crystalliu314/MMTK/Test Jig/renderWithBoard.JPG

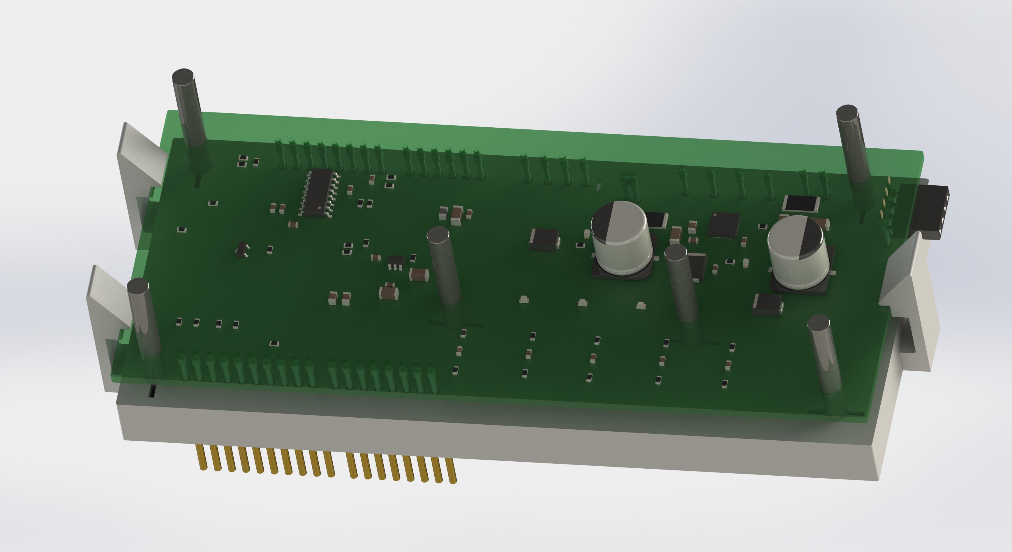
Test Jig/renderWithBoard.JPG
