crystalliu314/MMTK/Test Jig/MMTK - For Test Bed v1.5.step.SLDASM

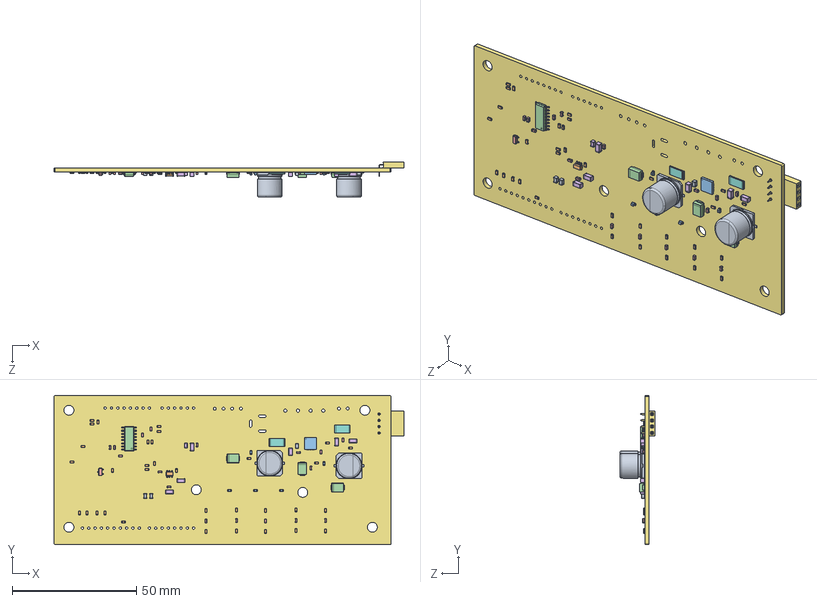
[picture p2: CAD file, 2020-12-12]
Test Jig/MMTK - For Test Bed v1.5.step.SLDASM
140.7 x 60.0 x 14.2 mm
SOLID.step x 3
SOLID-0.step x 33
SOLID-1.step x 5
SOLID-2.step x 3
SOLID-3.step x 17
SOLID-4.step x 6
SOLID-5.step
SOLID-6.step x 2
SOLID-7.step x 2
SOLID-8.step
SOLID-9.step
SOLID-10.step
SOLID-11.step
SOLID-12.step
COMPOUND.step
