crystalliu314/MMTK/Test Jig/MMTK - For Test Bed v1.5.SLDASM

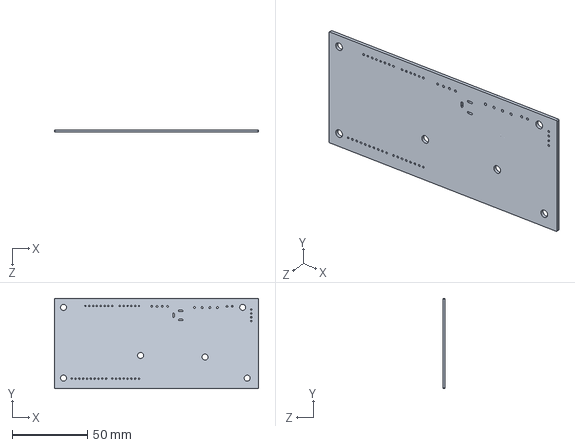
[picture p3: CAD file, 2020-12-12]
Test Jig/MMTK - For Test Bed v1.5.SLDASM
135.5 x 60.0 x 1.60 mm
