crystalliu314/MMTK/Test Jig/Pogo Pin/Pin Assembly.SLDASM

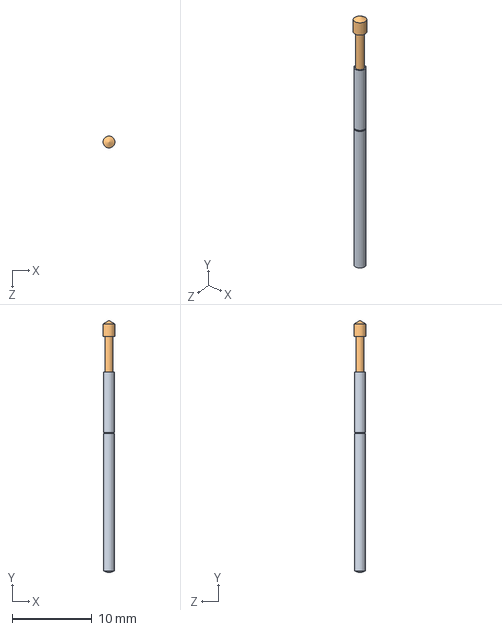
[picture p4: CAD file, 2020-12-12]
Test Jig/Pogo Pin/Pin Assembly.SLDASM
1.50 x 31.7 x 1.50 mm
Outer Sleeve
Inner Pin
