crystalliu314/MMTK/Test Jig/Pogo Pin/Test Jig With Pins.SLDASM

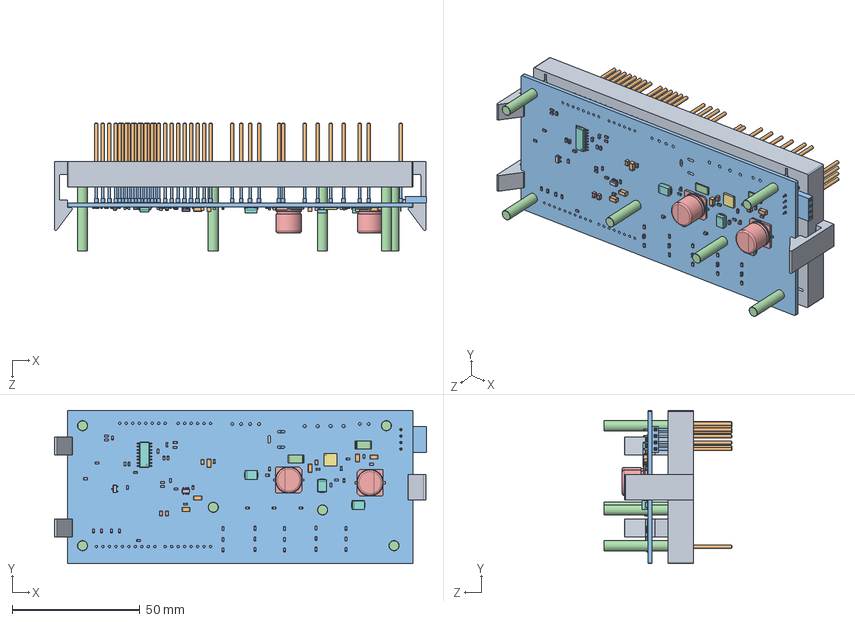
[picture p5: CAD file, 2020-12-12]
Test Jig/Pogo Pin/Test Jig With Pins.SLDASM
145.7 x 60.0 x 50.2 mm
Test Jig Pins Holder
Outer Sleeve x 50
Inner Pin x 50
4x30mm pin x 6
SOLID.step x 3
SOLID-0.step x 33
SOLID-1.step x 5
SOLID-2.step x 3
SOLID-3.step x 17
SOLID-4.step x 6
SOLID-5.step
SOLID-6.step x 2
SOLID-7.step x 2
SOLID-8.step
SOLID-9.step
SOLID-10.step
SOLID-11.step
SOLID-12.step
COMPOUND.step
