crystalliu314/MMTK/Test Jig/Pogo Pin/4x30mm pin.SLDPRT

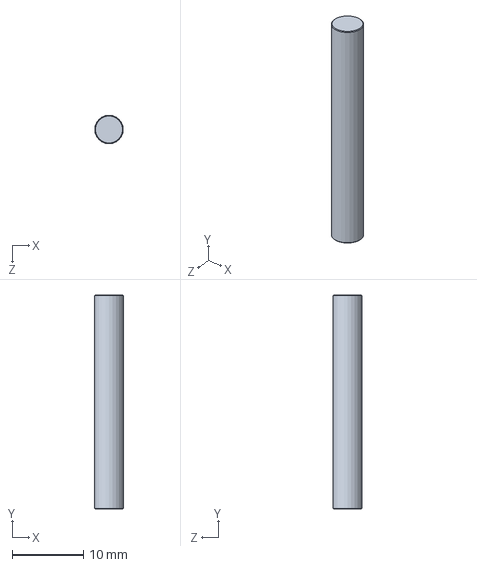
[picture p6: CAD file, 2020-12-12]
Test Jig/Pogo Pin/4x30mm pin.SLDPRT
4.00 x 30.0 x 4.00 mm
