crystalliu314/MMTK/Test Jig/Pogo Pin/Outer Sleeve.SLDPRT

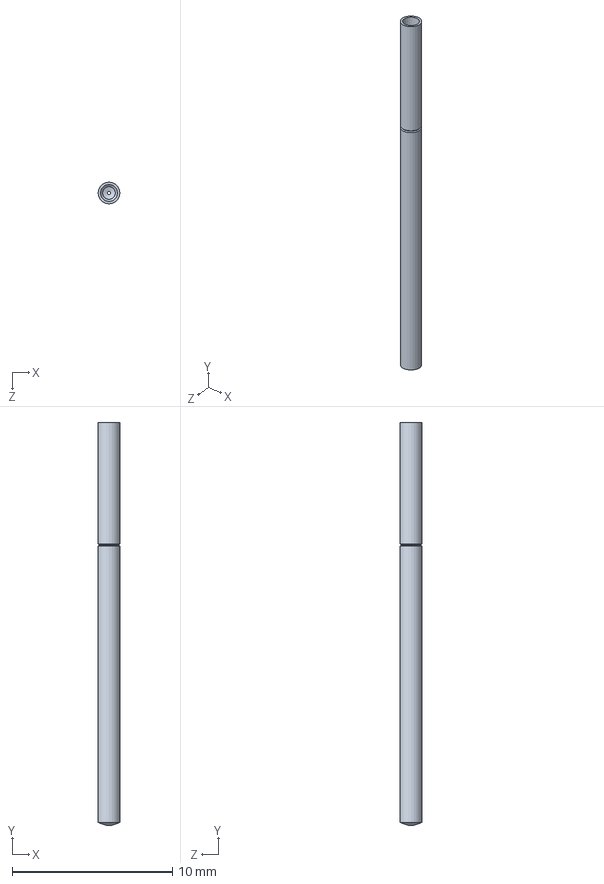
[picture p7: CAD file, 2020-12-12]
Test Jig/Pogo Pin/Outer Sleeve.SLDPRT
1.36 x 25.2 x 1.36 mm
