crystalliu314/MMTK/Test Jig/Test Jig Pins Holder.SLDPRT

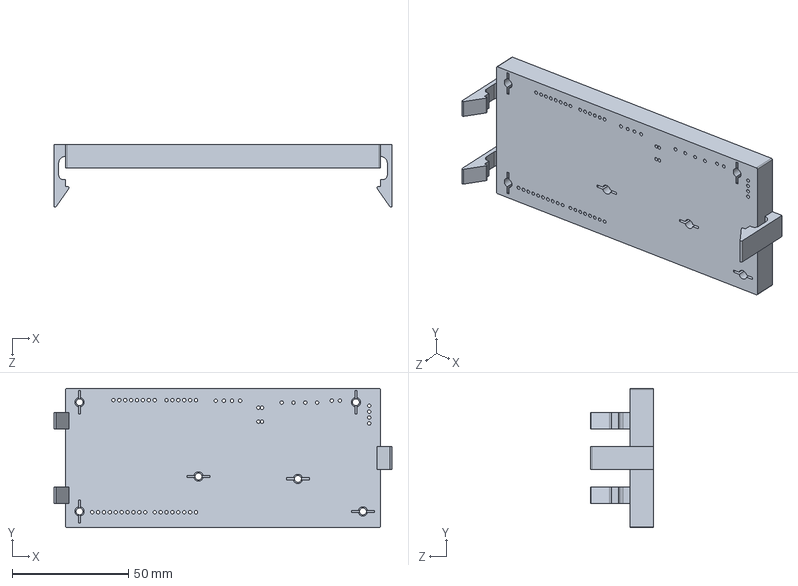
[picture p8: CAD file, 2020-12-12]
Test Jig/Test Jig Pins Holder.SLDPRT
145.5 x 60.0 x 26.9 mm
