crystalliu314/MMTK/Test Jig/Pogo Pin/Inner Pin.SLDPRT

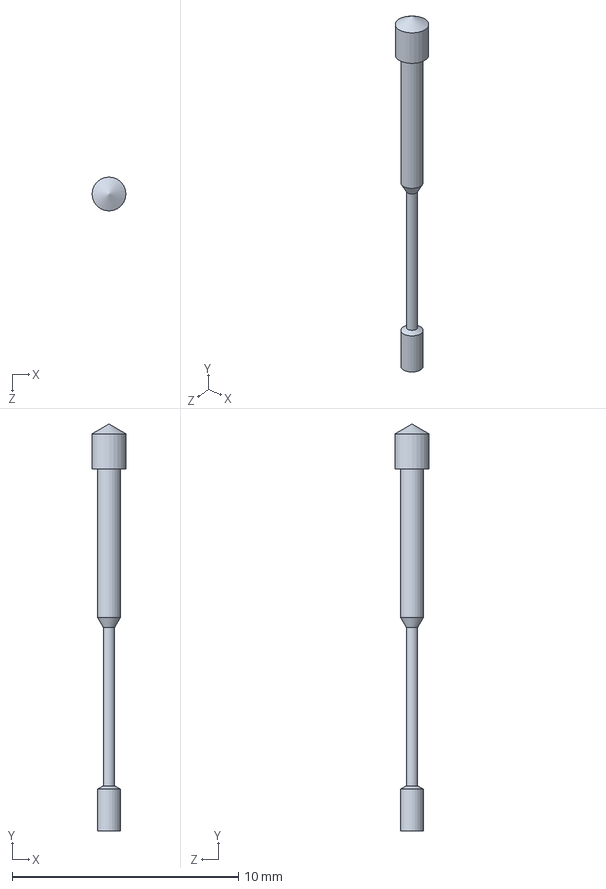
[picture p9: CAD file, 2020-12-12]
Test Jig/Pogo Pin/Inner Pin.SLDPRT
1.50 x 18.0 x 1.50 mm
