crystalliu314/MMTK/Test Jig/Test Holes Block.SLDPRT

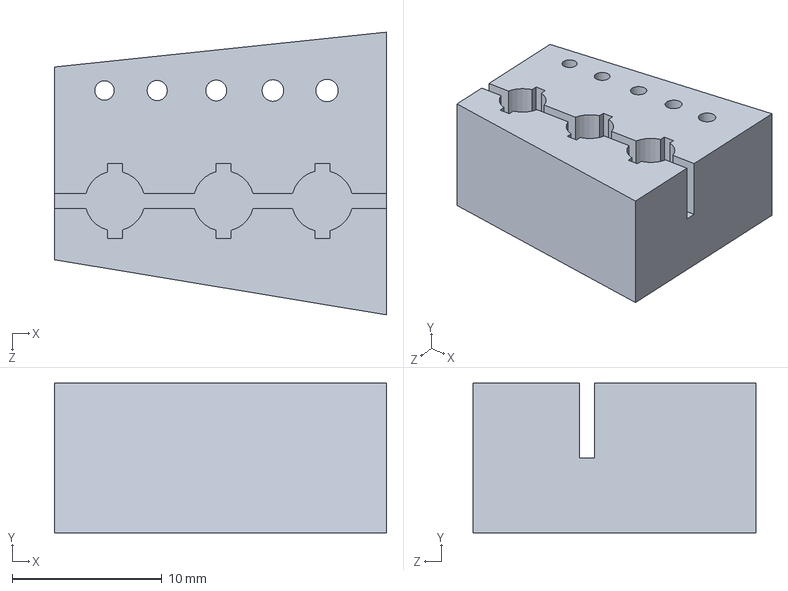
[picture p10: CAD file, 2020-12-12]
Test Jig/Test Holes Block.SLDPRT
22.2 x 10.0 x 18.9 mm
