crystalliu314/MMTK/(list of files, cad)

Other CAD files:
Test Jig/MMTK - For Test Bed v1.5.SLDPRT
Test Jig/Test Holes Block.3MF
Test Jig/Test Holes Block.STL
Test Jig/Test Jig Pins Holder.STL
