crystalliu314/MMTK/Test Data/MMTK First Tests.xlsx

Sheet: Sheet1
SPEED | POSITION | LOADCELL | FEEDBACK_COUNT | STATE | ESTOP | STALL | DIRECTION | INPUT_VOLTAGE | POSITION | LOADCELL
0 | 0 | 6.38 | 0 | 1 | 1 | 0 | 0 | 12.32 | 0.0625 | 6.38
0 | 0 | 6.39 | 0 | 1 | 1 | 0 | 0 | 12.27 | 0 | 6.39
0 | 0 | 6.39 | 0 | 1 | 1 | 0 | 0 | 12.3 | 0 | 6.39
0 | 0 | 6.39 | 0 | 1 | 1 | 0 | 0 | 12.21 | 0 | 6.39
0 | 0 | 6.39 | 0 | 1 | 1 | 0 | 0 | 12.3 | 0 | 6.39
0 | 0 | 6.38 | 0 | 1 | 1 | 0 | 0 | 12.17 | 0 | 6.38
0 | 0 | 6.38 | 0 | 1 | 1 | 0 | 0 | 12.29 | 0 | 6.38
0 | 0 | 6.38 | 0 | 1 | 1 | 0 | 0 | 12.17 | 0 | 6.38
0 | 0 | 6.37 | 0 | 1 | 1 | 0 | 0 | 12.23 | 0 | 6.37
0 | 0 | 6.38 | 0 | 1 | 1 | 0 | 0 | 12.32 | 0 | 6.38
0 | 0 | 6.37 | 0 | 1 | 1 | 0 | 0 | 12.17 | 0 | 6.37
0 | 0 | 6.38 | 0 | 1 | 1 | 0 | 0 | 12.27 | 0 | 6.38
0 | 0 | 6.39 | 0 | 1 | 1 | 0 | 0 | 12.34 | 0 | 6.39
0 | 0 | 6.39 | 0 | 1 | 1 | 0 | 0 | 12.17 | 0 | 6.39
0 | 0 | 6.41 | 0 | 2 | 1 | 0 | 0 | 12.27 | 0 | 6.41
0 | 0 | 6.39 | 0 | 2 | 0 | 0 | 0 | 12.11 | 0 | 6.39
0 | 0 | 6.37 | 0 | 2 | 0 | 0 | 0 | 12.23 | 0 | 6.37
0 | 0 | 6.37 | 0 | 2 | 0 | 0 | 0 | 12.11 | 0 | 6.37
0 | 0 | 6.38 | 0 | 2 | 0 | 0 | 0 | 12.17 | 0 | 6.38
0 | 0 | 6.36 | 0 | 2 | 0 | 0 | 0 | 12.27 | 0 | 6.36
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
