crystalliu314/MMTK/Test Jig/render.JPG

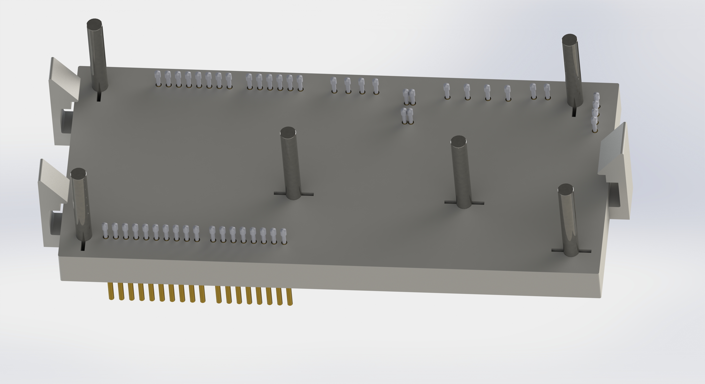
Test Jig/render.JPG
