crystalliu314/MMTK/PCB/MMTK.pdf

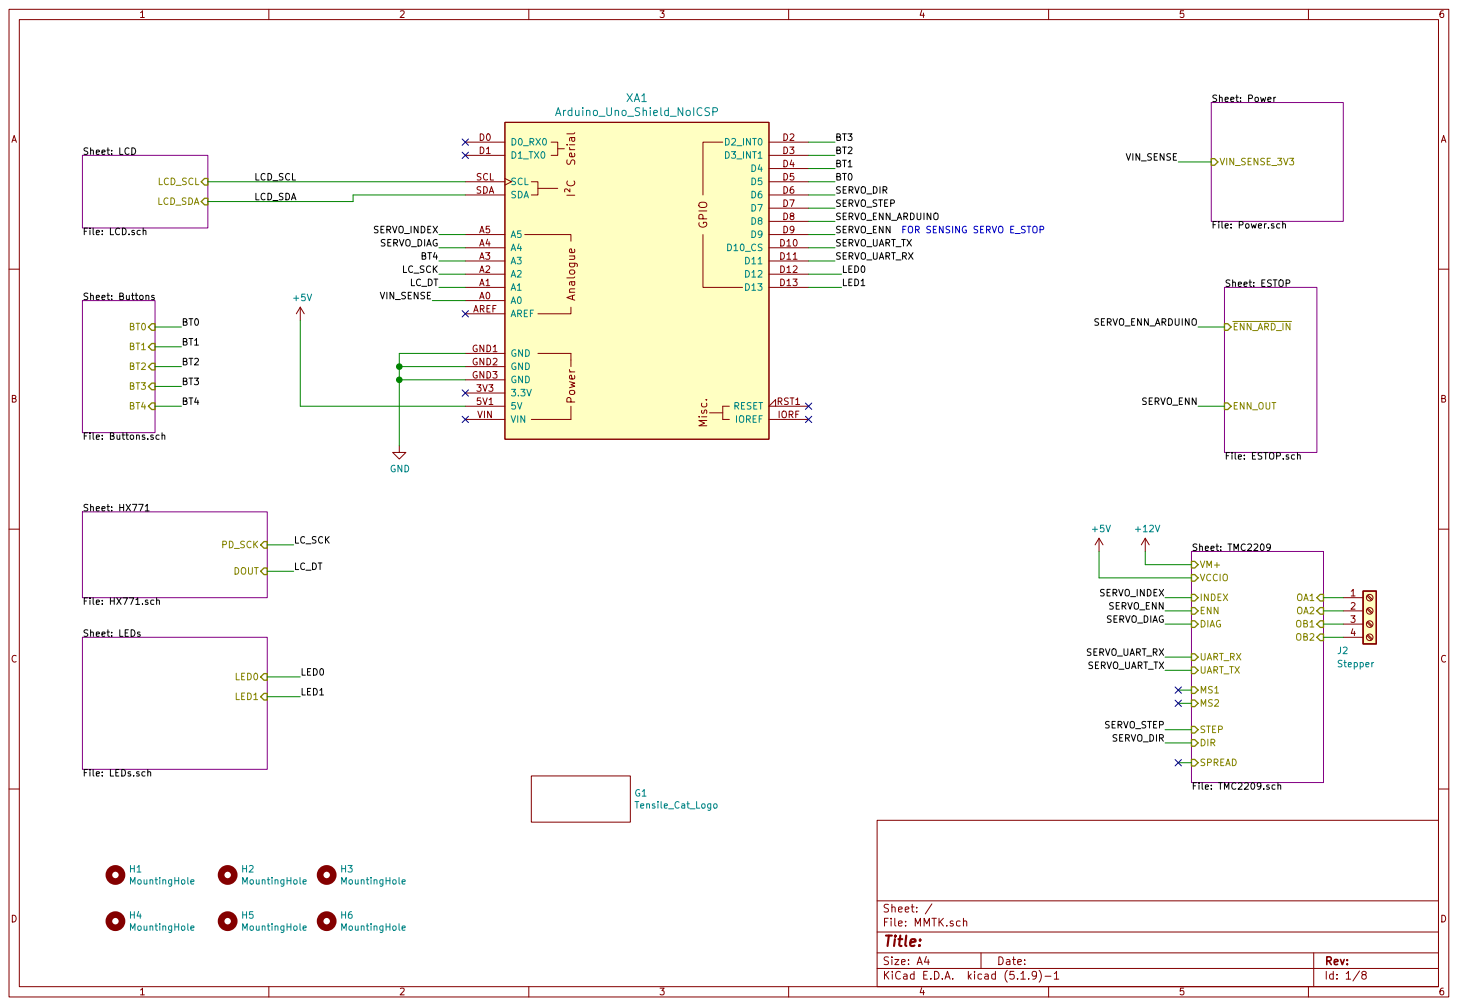
[picture p12: page 1]

Sheet: Power File: Power.sch VIN_SENSE_3V3

Id: 1/8 Title: File: MMTK.sch Sheet: /

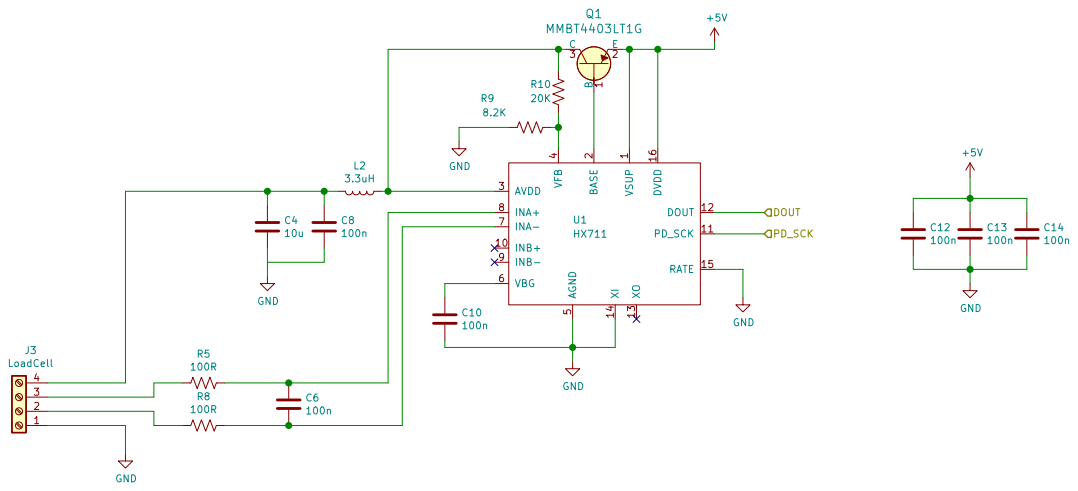
[picture p13: page 2]

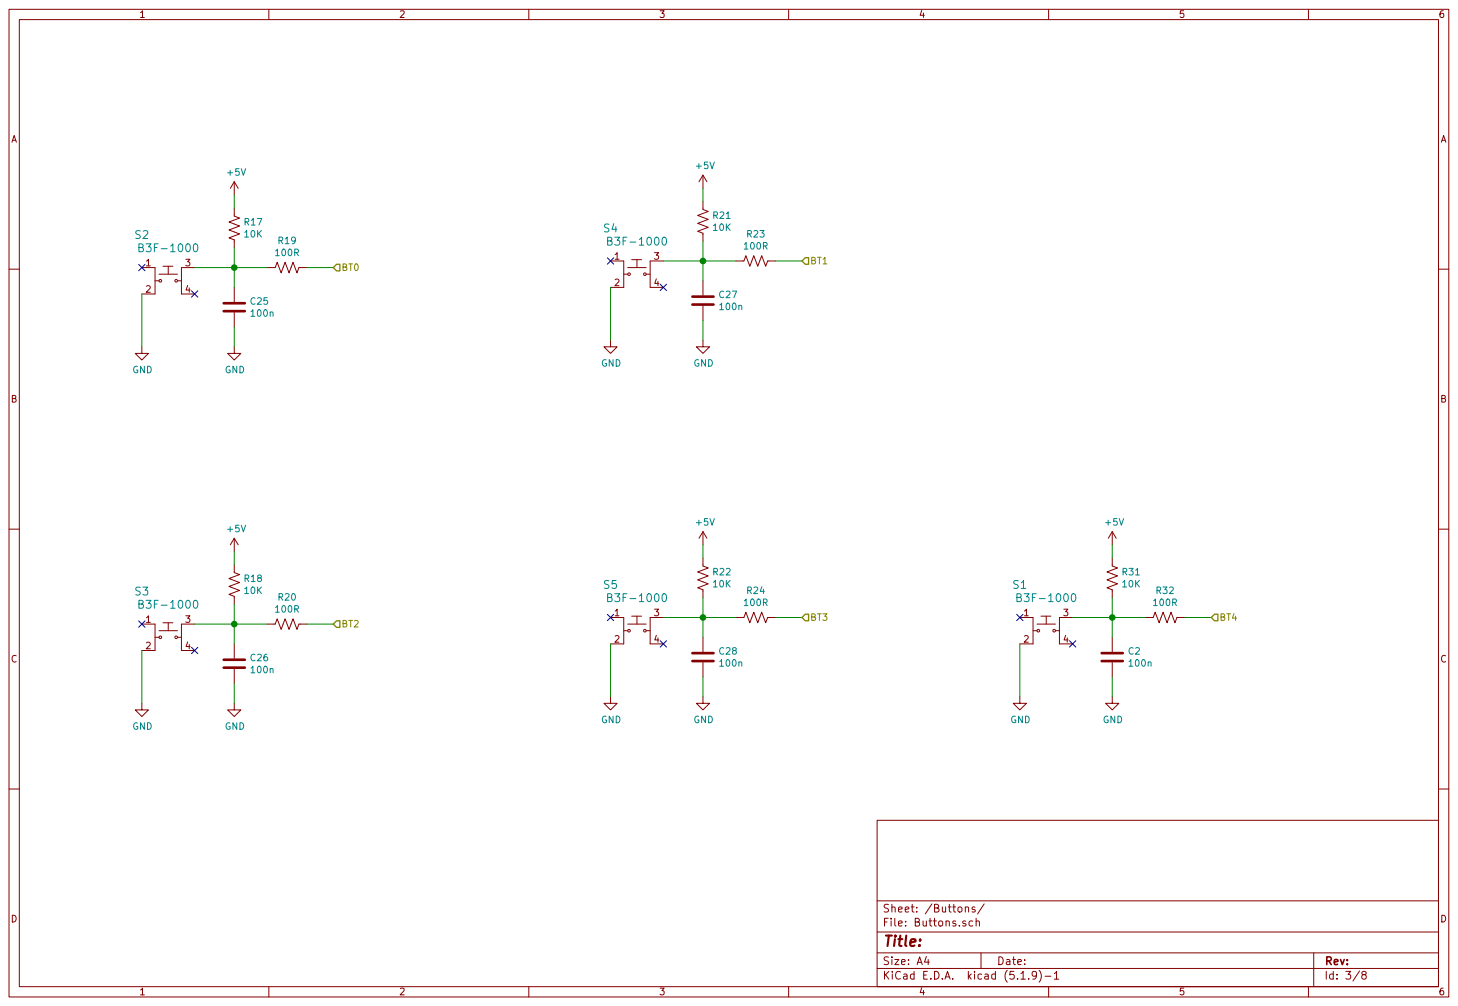
[picture p14: page 3]

Id: 3/8 Title: File: Buttons.sch Sheet: /Buttons/ R22

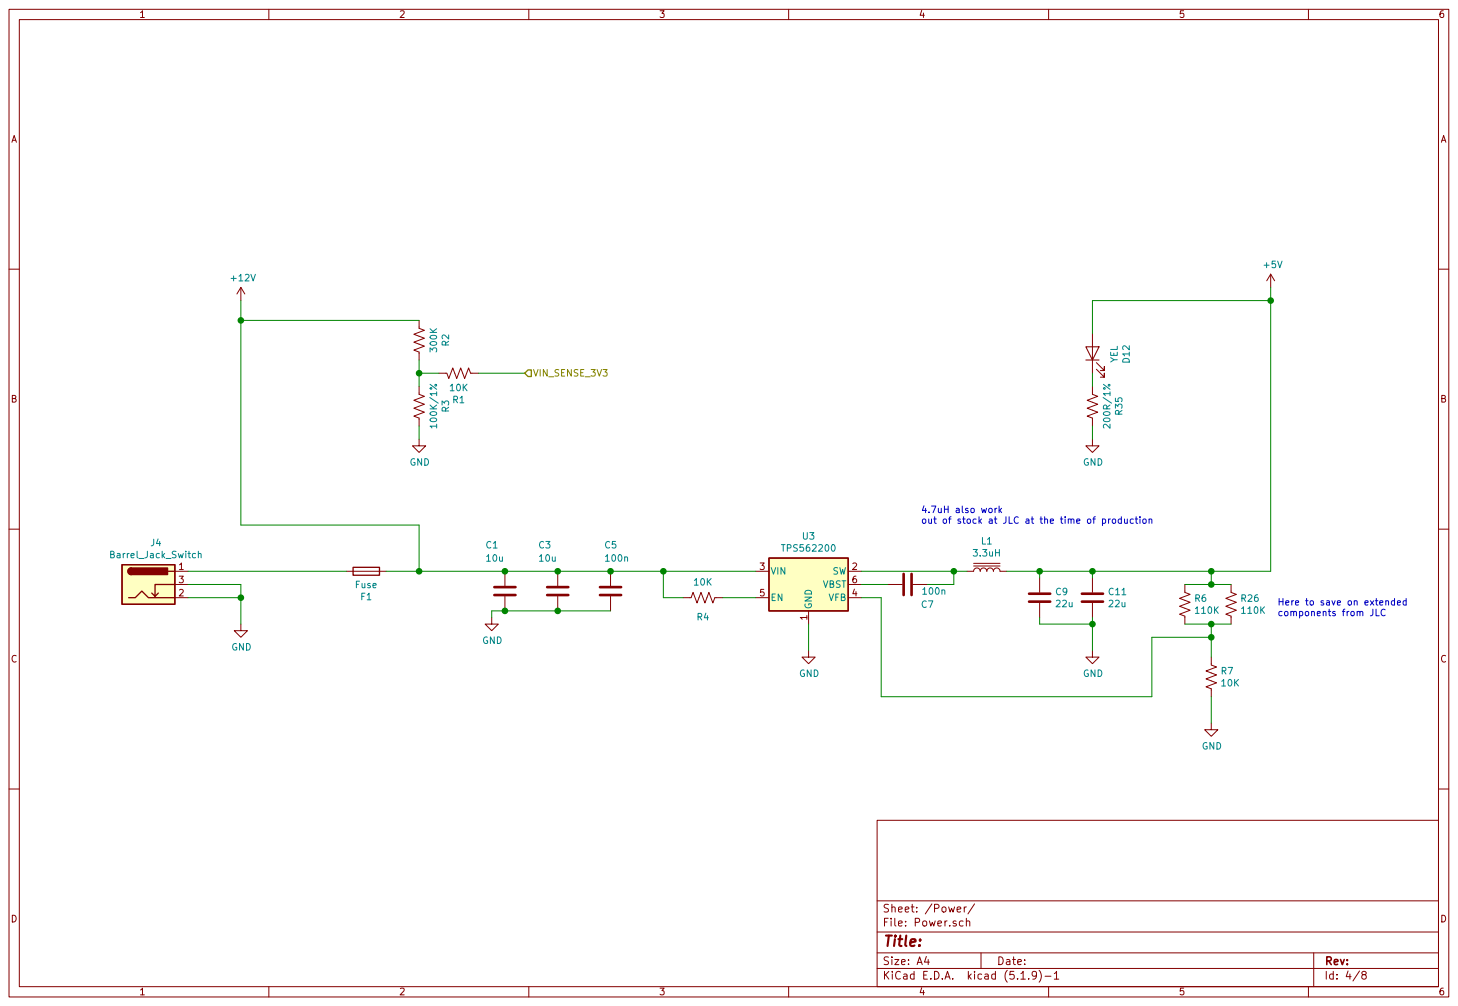
[picture p15: page 4]

4.7uH also work out of stock at JLC at the time of production

1 SW 2 VIN 3 VFB 4 EN 5 VBST 6 U3 TPS562200 GND R7

Id: 4/8 Title: File: Power.sch Sheet: /Power/ GND

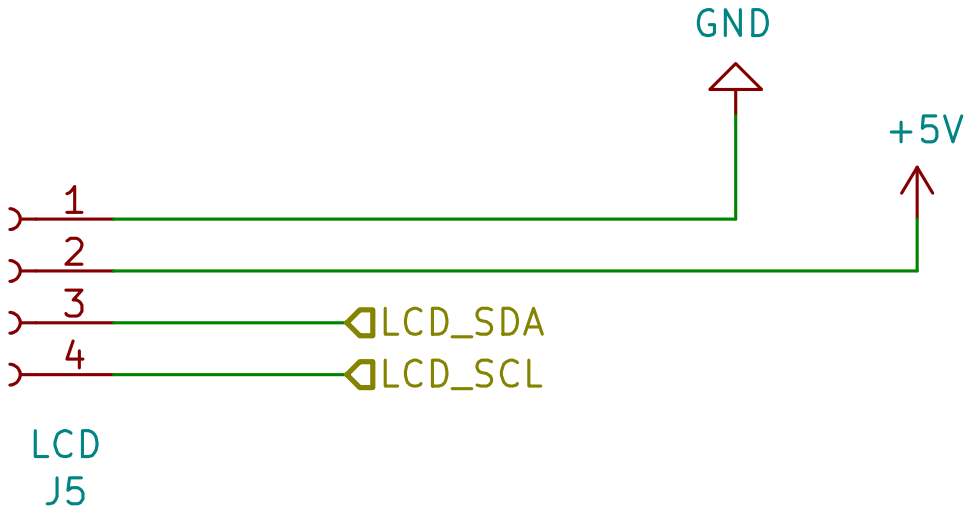
[picture p16: page 5]

Id: 5/8 Title: File: LCD.sch Sheet: /LCD/ GND

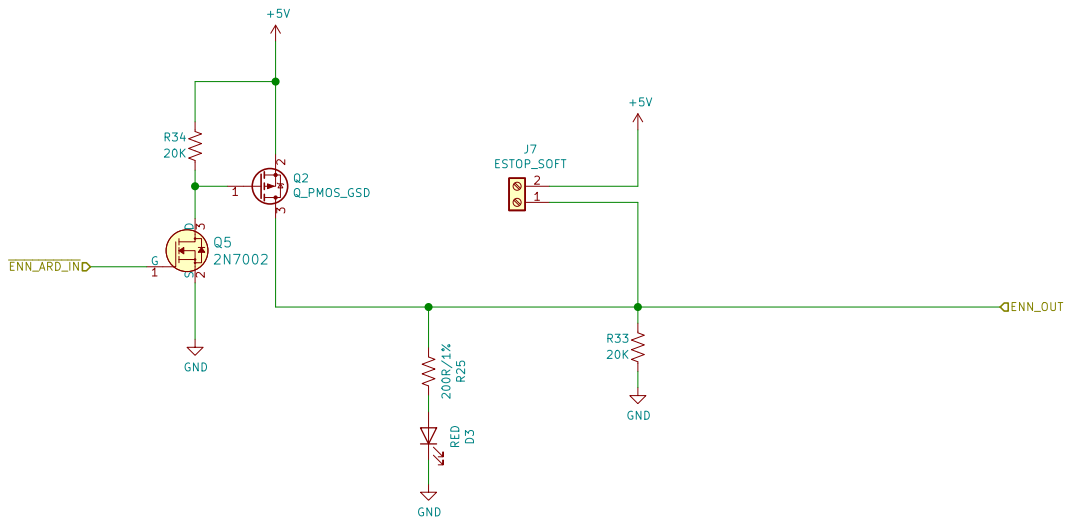
[picture p17: page 6]

Id: 6/8 Title: File: ESTOP.sch Sheet: /ESTOP/ R25 200R/1%

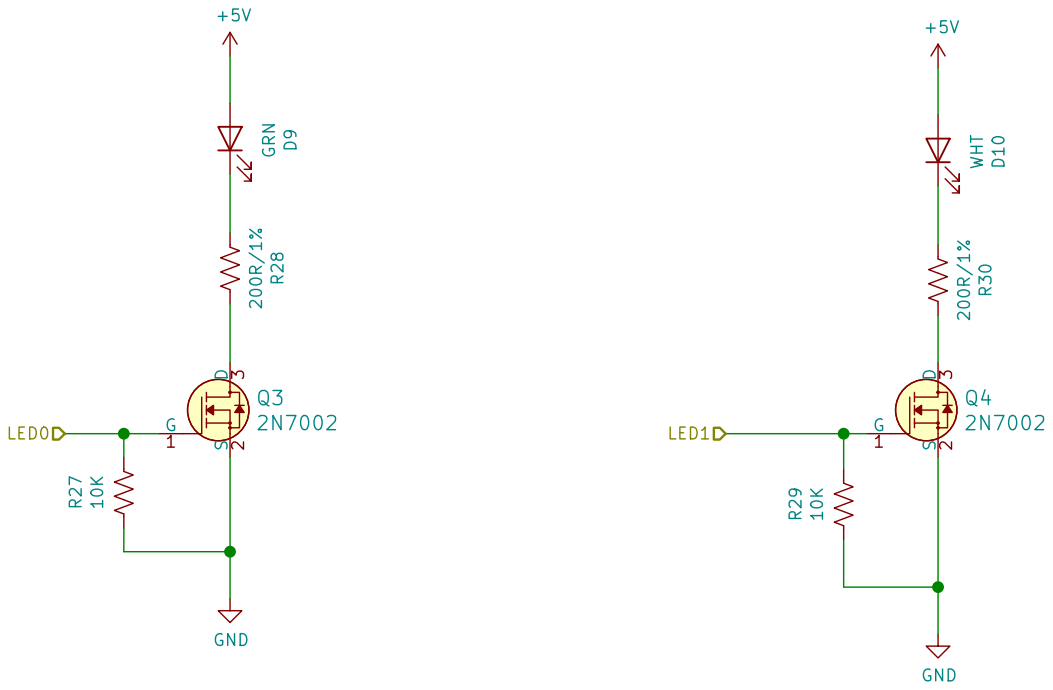
[picture p18: page 7]

Id: 7/8 Title: File: LEDs.sch Sheet: /LEDs/

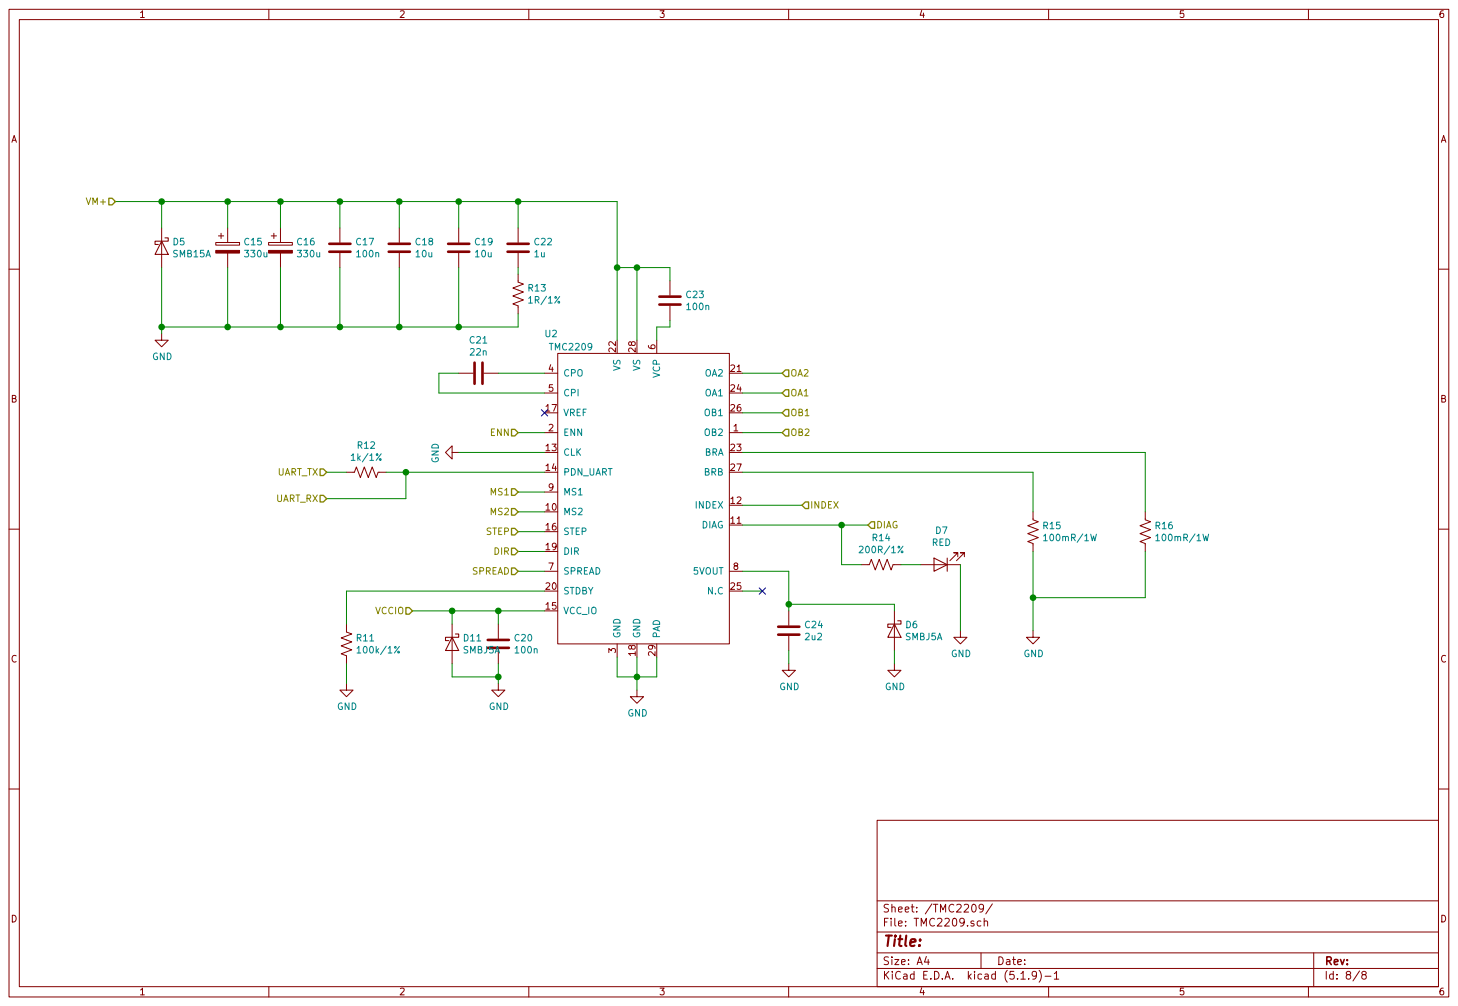
[picture p19: page 8]

Id: 8/8 Title: File: TMC2209.sch Sheet: /TMC2209/
