crystalliu314/MMTK/PCB/MMTK.kicad_pcb

## KiCad design PCB/MMTK.kicad_pcb (2025-04-05)

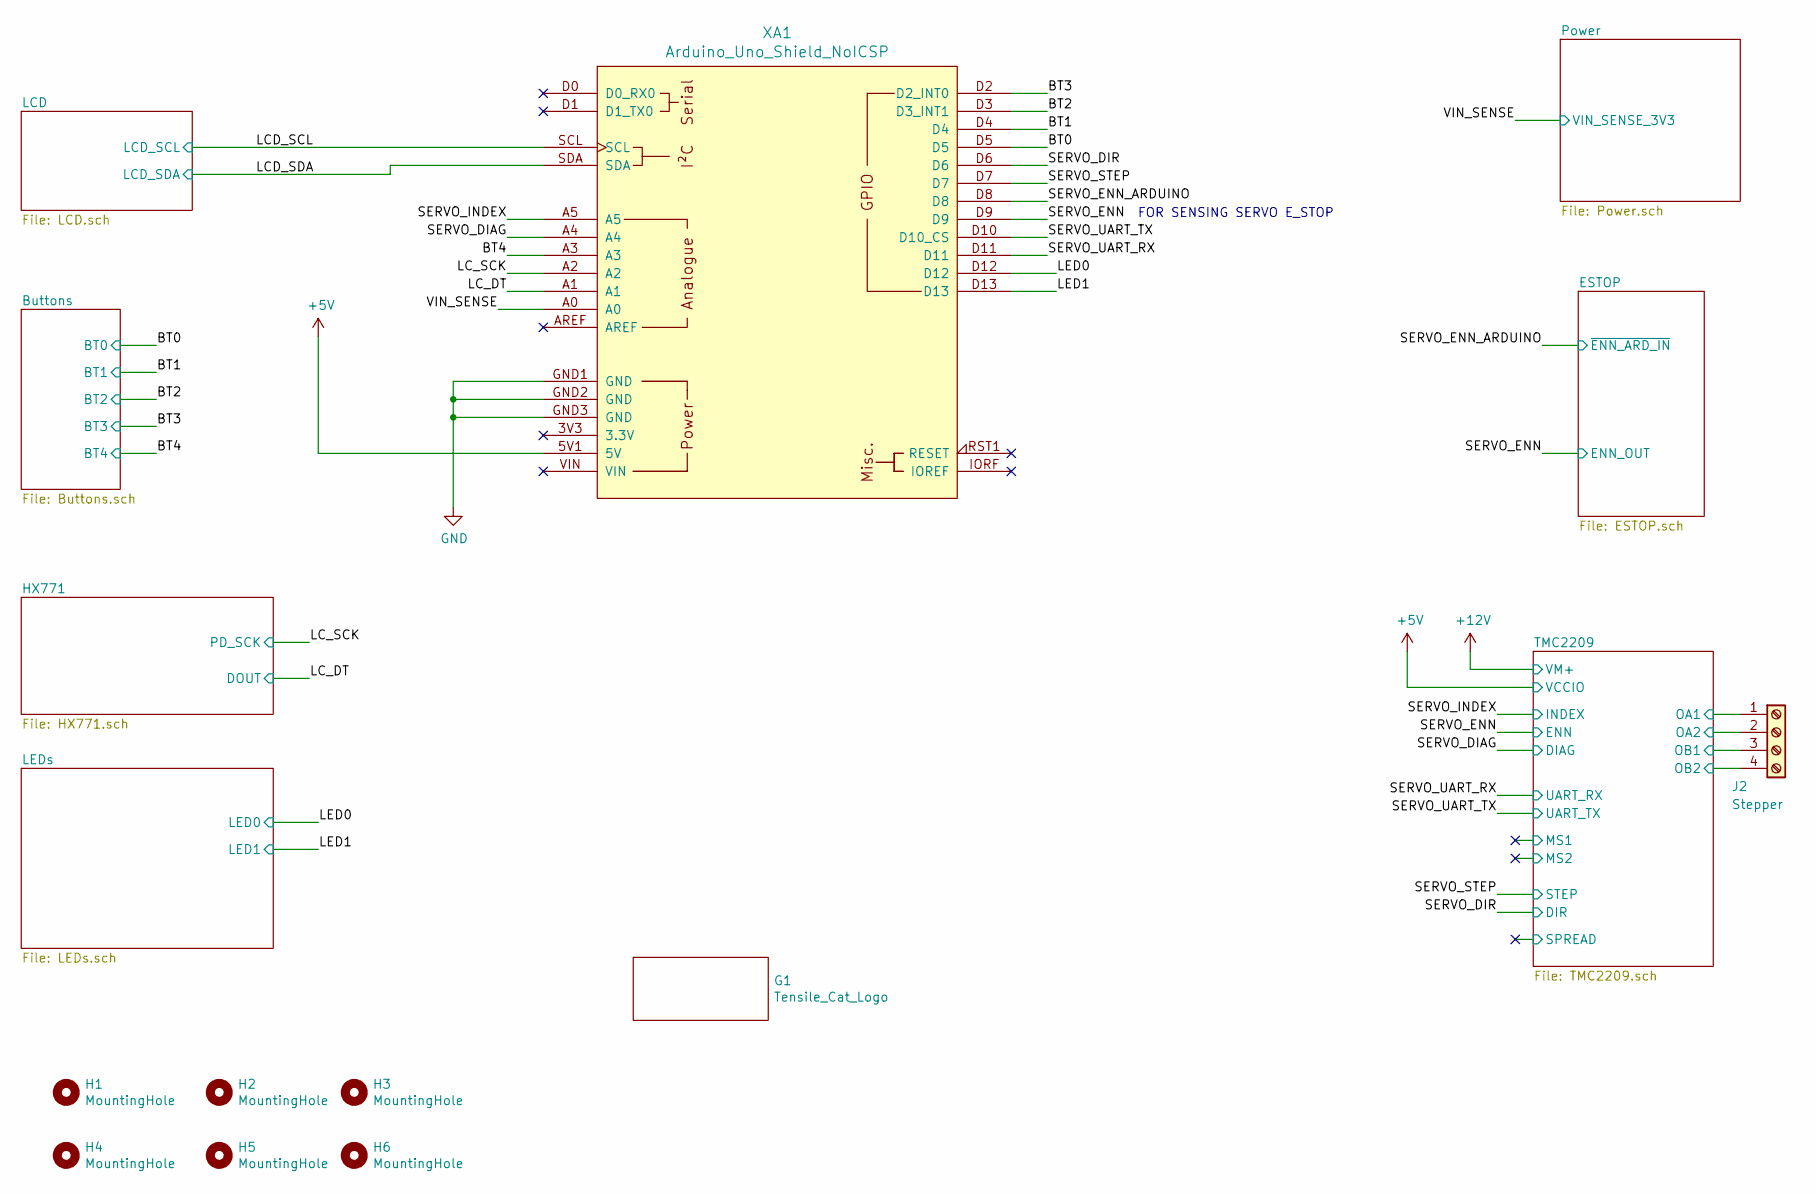
[picture p20: schematic MMTK.sch]

Parts:
G1: Tensile_Cat_Logo; Tensile Cat
H1, H2, H3, H4, H5, H6: MountingHole; MountingHole_4mm
J2: Stepper; TerminalBlock_RND_205-00289_1x04_P5.08mm_Horizontal
XA1: Arduino_Uno_Shield_NoICSP

Connections:
+5V: XA1.5V1 (5V); also elsewhere on the board
/BT0: XA1.D5; also elsewhere on the board
/BT1: XA1.D4; also elsewhere on the board
/BT2: XA1.D3 (D3_INT1); also elsewhere on the board
/BT3: XA1.D2 (D2_INT0); also elsewhere on the board
/BT4: XA1.A3; also elsewhere on the board
/LCD_SCL: XA1.SCL; also elsewhere on the board
/LCD_SDA: XA1.SDA; also elsewhere on the board
/LC_DT: XA1.A1; also elsewhere on the board
/LC_SCK: XA1.A2; also elsewhere on the board
/LED0: XA1.D12; also elsewhere on the board
/LED1: XA1.D13; also elsewhere on the board
/SERVO_DIAG: XA1.A4; also elsewhere on the board
/SERVO_DIR: XA1.D6; also elsewhere on the board
/SERVO_ENN: XA1.D9; also elsewhere on the board
/SERVO_ENN_ARDUINO: XA1.D8; also elsewhere on the board
/SERVO_INDEX: XA1.A5; also elsewhere on the board
/SERVO_STEP: XA1.D7; also elsewhere on the board
/SERVO_UART_RX: XA1.D11; also elsewhere on the board
/SERVO_UART_TX: XA1.D10 (D10_CS); also elsewhere on the board
/TMC2209/OA1: J2.1; also elsewhere on the board
/TMC2209/OA2: J2.2; also elsewhere on the board
/TMC2209/OB1: J2.3; also elsewhere on the board
/TMC2209/OB2: J2.4; also elsewhere on the board
/VIN_SENSE: XA1.A0; also elsewhere on the board
GND: XA1.GND1 (GND), XA1.GND2 (GND), XA1.GND3 (GND); also elsewhere on the board

Notes on the sheet:
FOR SENSING SERVO E_STOP

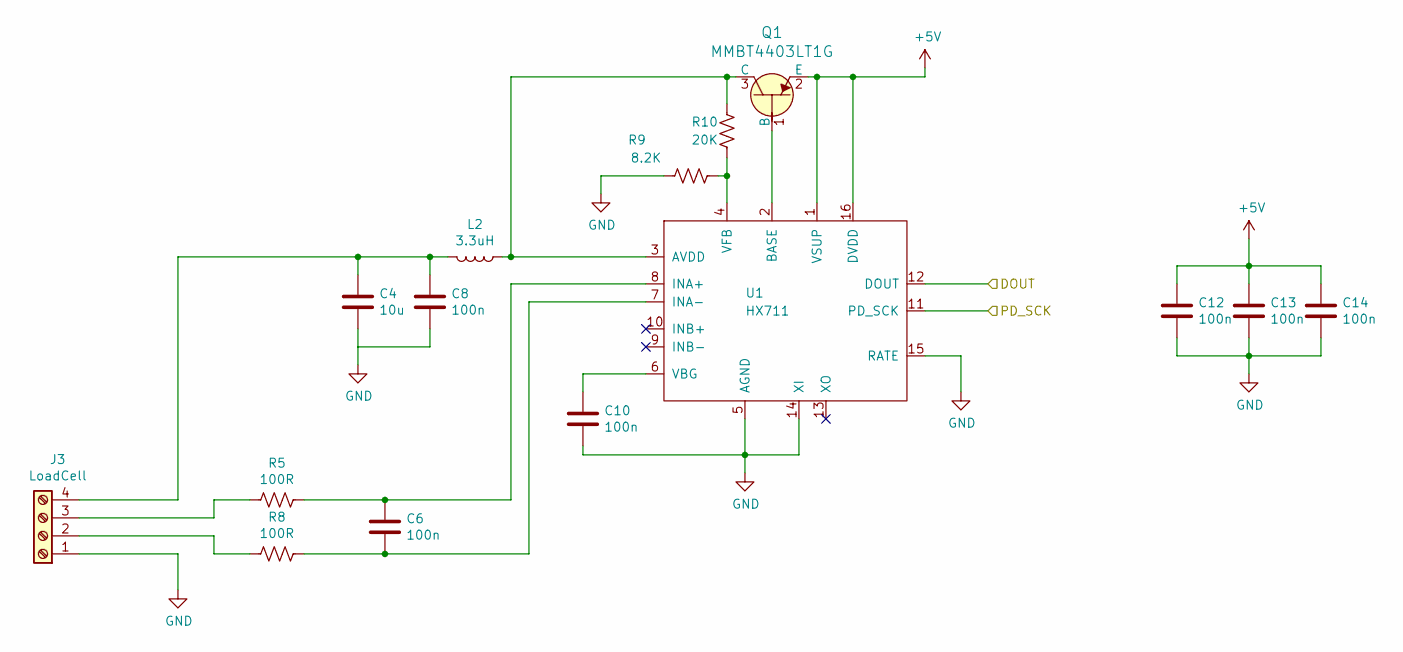
[picture p21: schematic HX771.sch]

Parts:
C4: 10u; C_1206_3216Metric
C6, C8, C10, C12, C13, C14: 100n; C_0603_1608Metric
J3: LoadCell; TerminalBlock_Phoenix_PT-1,5-4-3.5-H_1x04_P3.50mm_Horizontal
L2: 3.3uH; L_0805_2012Metric
Q1: MMBT4403LT1G; SOT-23-3; MPN MMBT4403LT1G; Digi-Key_PN MMBT4403LT1GOSCT-ND
R5, R8: 100R; R_0603_1608Metric
R9: 8.2K; R_0603_1608Metric
R10: 20K; R_0603_1608Metric
U1: HX711; SOIC-16_3.9x9.9mm_P1.27mm

Connections:
+5V: C12.1, C13.1, C14.1, Q1.2 (E), U1.1 (VSUP), U1.16 (DVDD); also elsewhere on the board
/LC_DT: U1.12 (DOUT); also elsewhere on the board
/LC_SCK: U1.11 (PD_SCK); also elsewhere on the board
GND: C4.2, C8.2, C10.2, C12.2, C13.2, C14.2, J3.1, R9.1, U1.5 (AGND), U1.14 (XI), U1.15 (RATE); also elsewhere on the board
unnamed: C4.1, C8.1, J3.4, L2.2
unnamed: C6.1, R5.1, U1.8 (INA+)
unnamed: C6.2, R8.1, U1.7 (INA-)
unnamed: C10.1, U1.6 (VBG)
unnamed: J3.2, R8.2
unnamed: J3.3, R5.2
unnamed: L2.1, Q1.3 (C), R10.2, U1.3 (AVDD)
unnamed: Q1.1 (B), U1.2 (BASE)
unnamed: R9.2, R10.1, U1.4 (VFB)

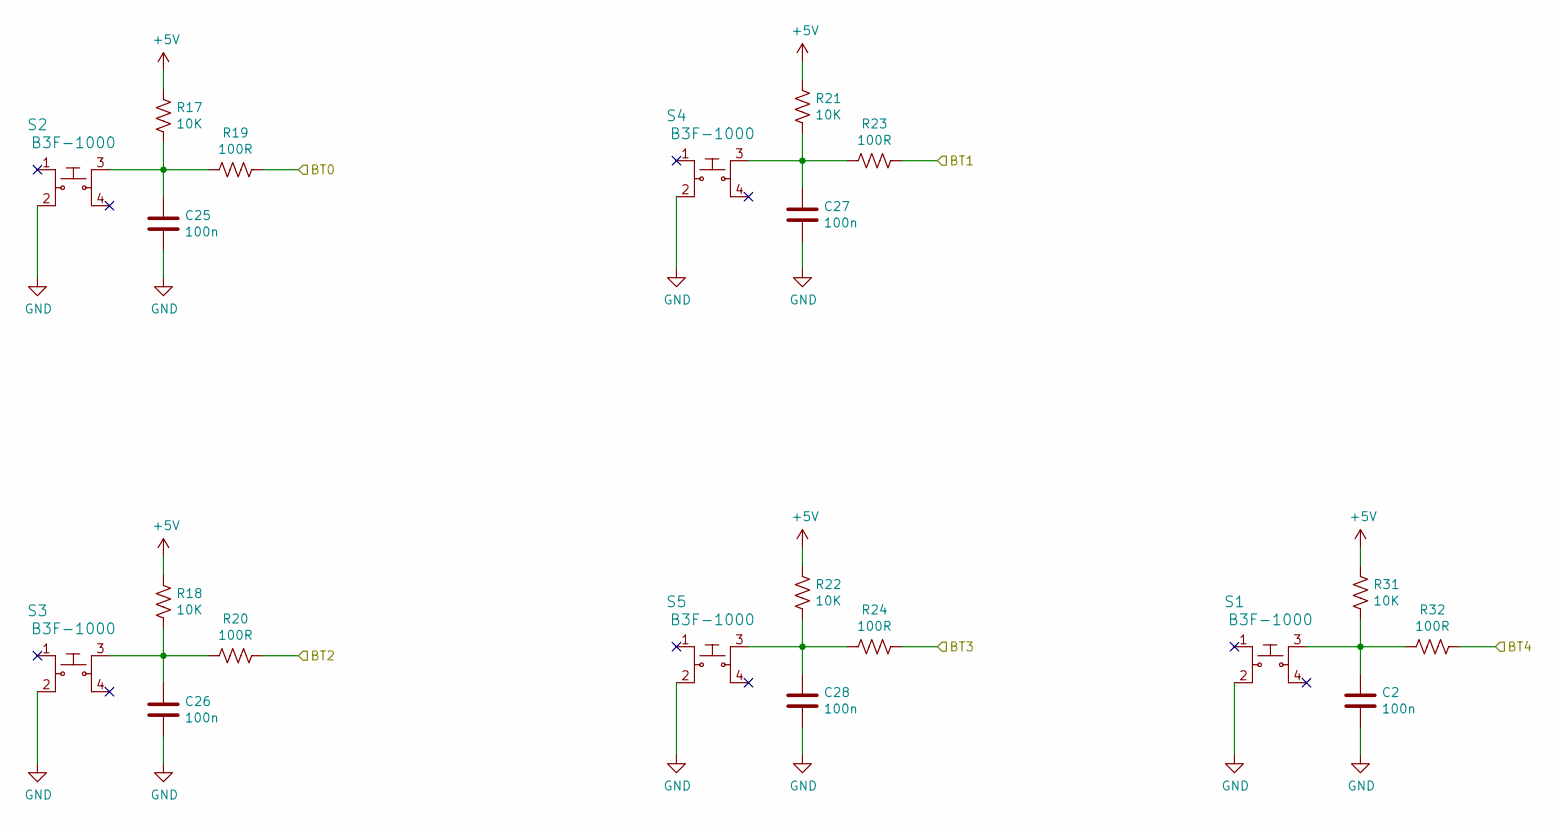
[picture p22: schematic Buttons.sch]

Parts:
C2, C25, C26, C27, C28: 100n; C_0603_1608Metric
R17, R18, R21, R22, R31: 10K; R_0603_1608Metric
R19, R20, R23, R24, R32: 100R; R_0603_1608Metric
S1, S2, S3, S4, S5: B3F-1000; Switch_Tactile_SMD_6x6mm; MPN B3F-1000; Digi-Key_PN SW400-ND

Connections:
+5V: R17.1, R18.1, R21.1, R22.1, R31.1; also elsewhere on the board
/BT0: R19.1; also elsewhere on the board
/BT1: R23.1; also elsewhere on the board
/BT2: R20.1; also elsewhere on the board
/BT3: R24.1; also elsewhere on the board
/BT4: R32.1; also elsewhere on the board
GND: C2.2, C25.2, C26.2, C27.2, C28.2, S1.2, S2.2, S3.2, S4.2, S5.2; also elsewhere on the board
unnamed: C2.1, R31.2, R32.2, S1.3
unnamed: C25.1, R17.2, R19.2, S2.3
unnamed: C26.1, R18.2, R20.2, S3.3
unnamed: C27.1, R21.2, R23.2, S4.3
unnamed: C28.1, R22.2, R24.2, S5.3

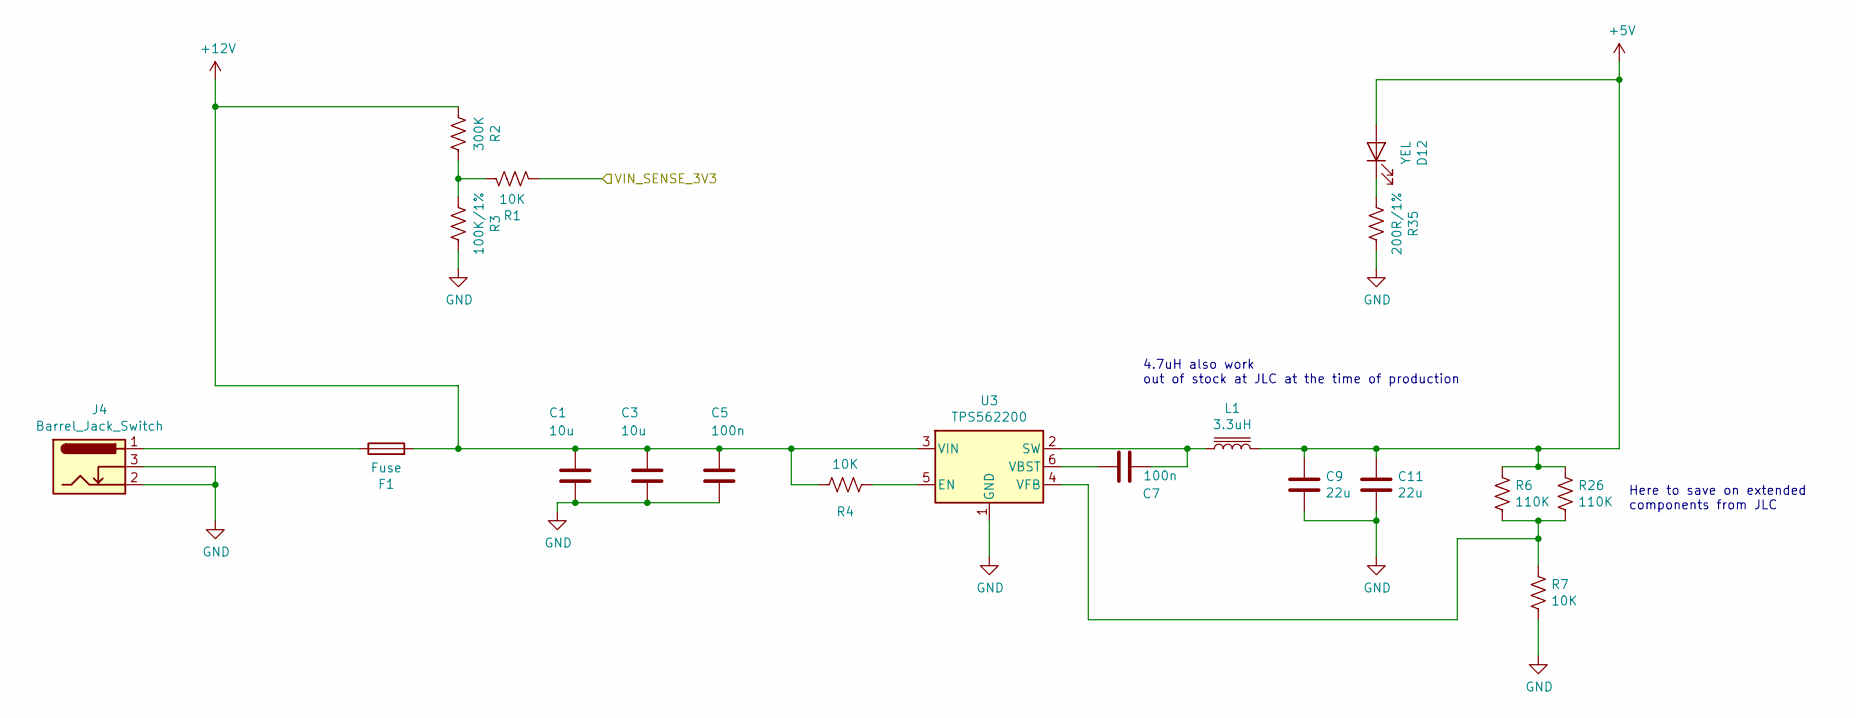
[picture p23: schematic Power.sch]

Parts:
C1, C3: 10u; C_1206_3216Metric
C5, C7: 100n; C_0603_1608Metric
C9, C11: 22u; C_0805_2012Metric
D12: YEL; LED_0603_1608Metric
F1: Fuse; Fuse_2920_7451Metric
J4: Barrel_Jack_Switch; BarrelJack_Horizontal
L1: 3.3uH; L_Bourns_SRP7028A_7.3x6.6mm
R1, R4, R7: 10K; R_0603_1608Metric
R2: 300K; R_0603_1608Metric
R3: 100K/1%; R_0603_1608Metric
R6, R26: 110K; R_0603_1608Metric
R35: 200R/1%; R_0603_1608Metric
U3: TPS562200; SOT-23-6

Connections:
+5V: C9.1, C11.1, D12.2 (A), L1.2, R6.1, R26.1; also elsewhere on the board
+12V: C1.1, C3.1, C5.1, F1.2, R2.2, R4.1, U3.3 (VIN); also elsewhere on the board
/VIN_SENSE: R1.1; also elsewhere on the board
GND: C1.2, C3.2, C5.2, C9.2, C11.2, J4.2, J4.3, R3.1, R7.2, R35.1, U3.1 (GND); also elsewhere on the board
unnamed: C7.1, L1.1, U3.2 (SW)
unnamed: C7.2, U3.6 (VBST)
unnamed: D12.1 (K), R35.2
unnamed: F1.1, J4.1
unnamed: R1.2, R2.1, R3.2
unnamed: R4.2, U3.5 (EN)
unnamed: R6.2, R7.1, R26.2, U3.4 (VFB)

Notes on the sheet:
Here to save on extended components from JLC
4.7uH also work out of stock at JLC at the time of production

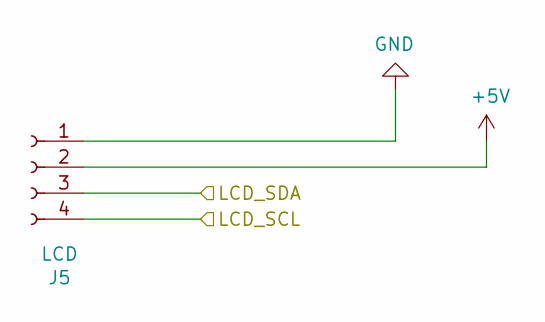
[picture p24: schematic LCD.sch]

Parts:
J5: LCD; PinSocket_1x04_P2.54mm_Horizontal

Connections:
+5V: J5.2; also elsewhere on the board
/LCD_SCL: J5.4; also elsewhere on the board
/LCD_SDA: J5.3; also elsewhere on the board
GND: J5.1; also elsewhere on the board

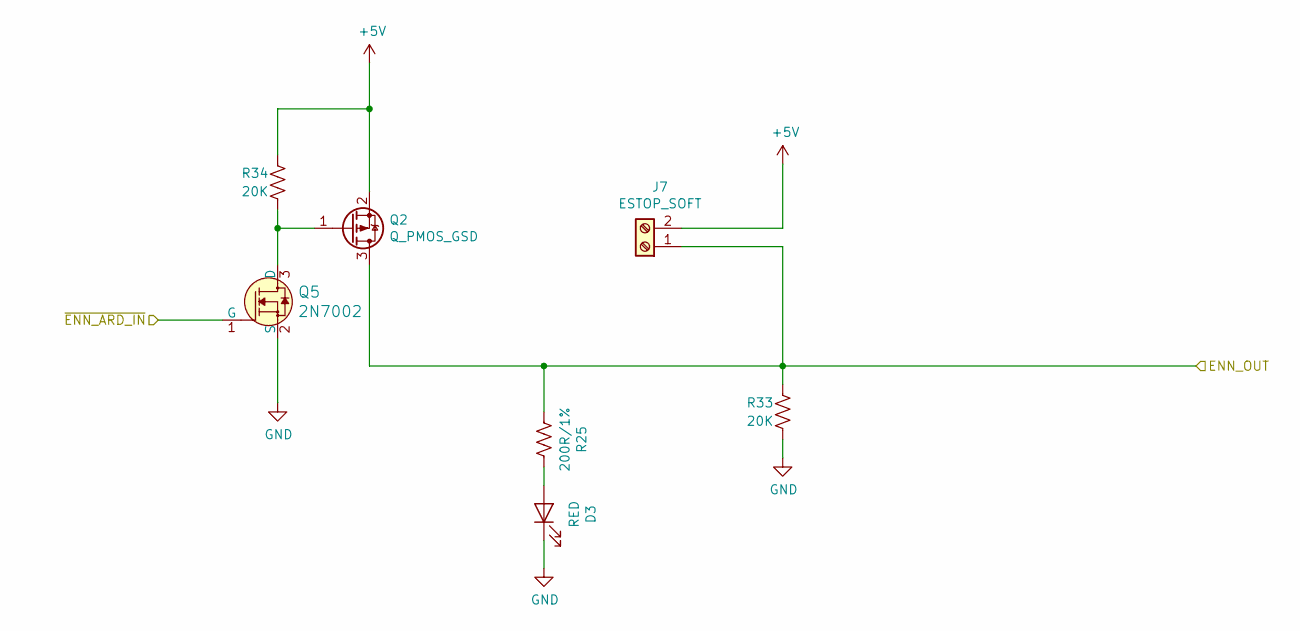
[picture p25: schematic ESTOP.sch]

Parts:
D3: RED; LED_0603_1608Metric
J7: ESTOP_SOFT; TerminalBlock_Phoenix_PT-1,5-2-3.5-H_1x02_P3.50mm_Horizontal
Q2: Q_PMOS_GSD; SOT-23
Q5: 2N7002; SOT-23-3; MPN 2N7002; Digi-Key_PN 2N7002NCT-ND
R25: 200R/1%; R_0603_1608Metric
R33, R34: 20K; R_0603_1608Metric

Connections:
+5V: J7.2, Q2.2 (S), R34.2; also elsewhere on the board
/SERVO_ENN: J7.1, Q2.3 (D), R25.2, R33.2; also elsewhere on the board
/SERVO_ENN_ARDUINO: Q5.1 (G); also elsewhere on the board
GND: D3.1 (K), Q5.2 (S), R33.1; also elsewhere on the board
unnamed: D3.2 (A), R25.1
unnamed: Q2.1 (G), Q5.3 (D), R34.1

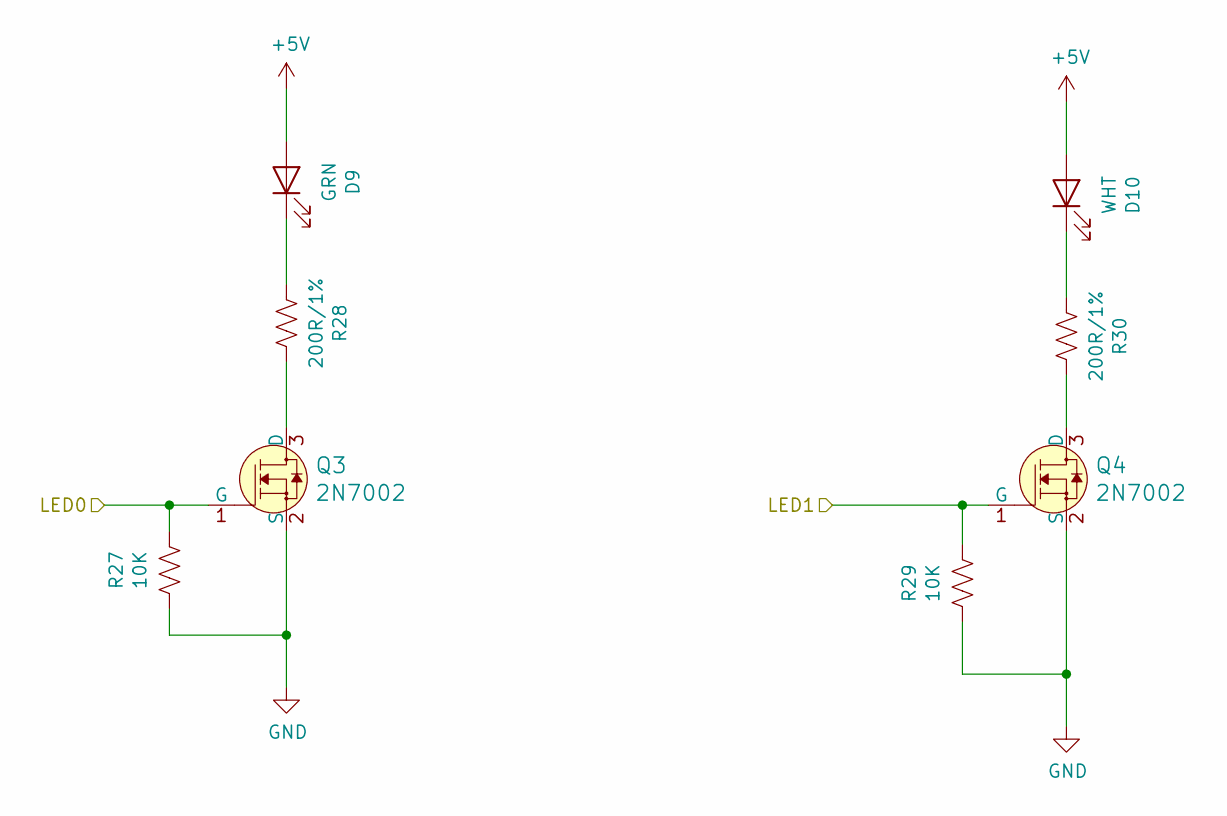
[picture p26: schematic LEDs.sch]

Parts:
D9: GRN; LED_0603_1608Metric
D10: WHT; LED_0603_1608Metric
Q3, Q4: 2N7002; SOT-23-3; MPN 2N7002; Digi-Key_PN 2N7002NCT-ND
R27, R29: 10K; R_0603_1608Metric
R28, R30: 200R/1%; R_0603_1608Metric

Connections:
+5V: D9.2 (A), D10.2 (A); also elsewhere on the board
/LED0: Q3.1 (G), R27.1; also elsewhere on the board
/LED1: Q4.1 (G), R29.1; also elsewhere on the board
GND: Q3.2 (S), Q4.2 (S), R27.2, R29.2; also elsewhere on the board
unnamed: D9.1 (K), R28.2
unnamed: D10.1 (K), R30.2
unnamed: Q3.3 (D), R28.1
unnamed: Q4.3 (D), R30.1

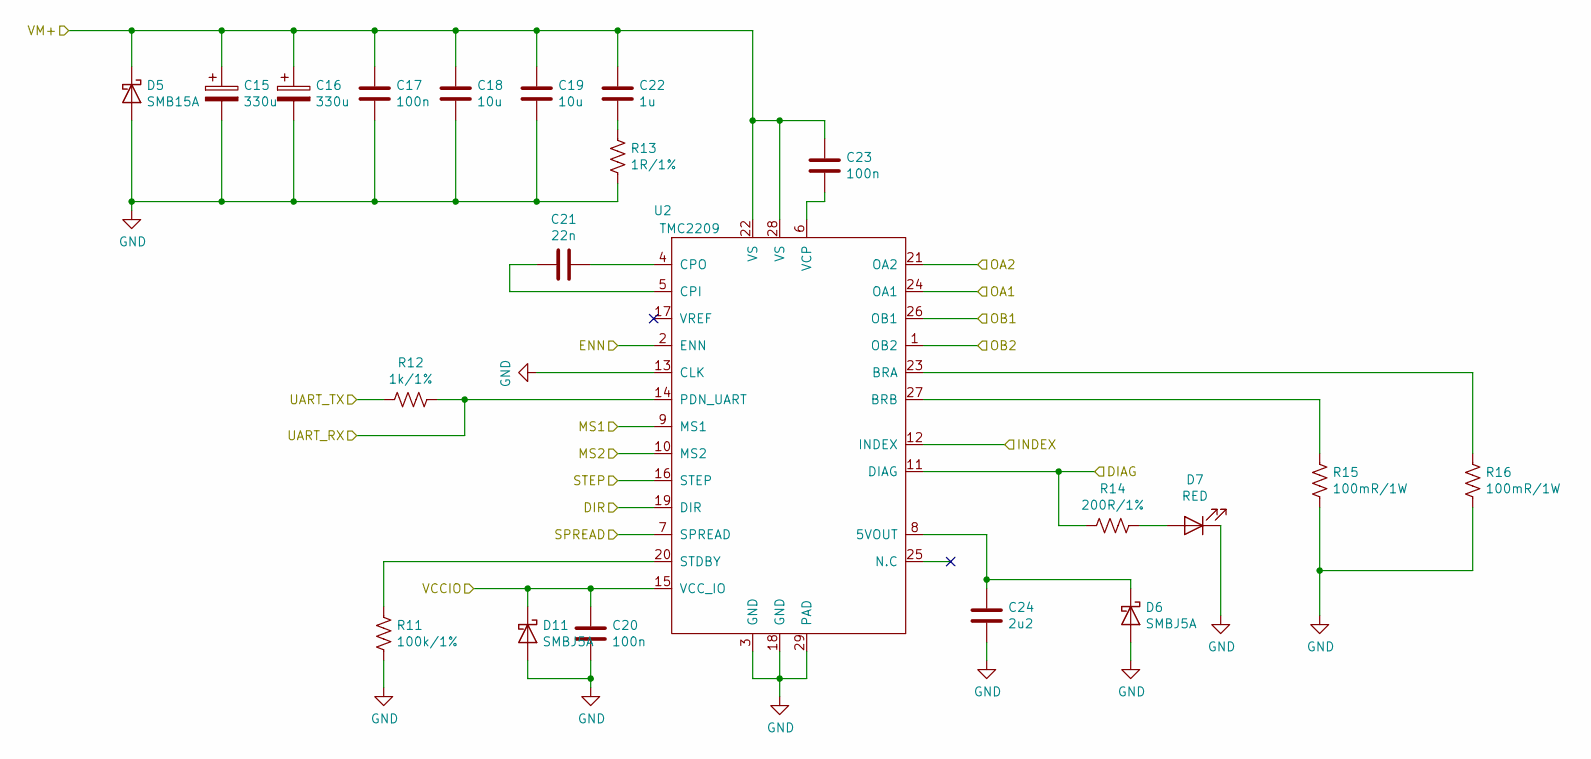
[picture p27: schematic TMC2209.sch]

Parts:
C15, C16: 330u; CP_Elec_10x10
C17, C20, C23: 100n; C_0603_1608Metric
C18, C19: 10u; C_1206_3216Metric
C21: 22n; C_0805_2012Metric
C22: 1u; C_1206_3216Metric
C24: 2u2; C_0603_1608Metric
D5: SMB15A; D_SMB
D6, D11: SMBJ5A; D_SMB
D7: RED; LED_0603_1608Metric
R11: 100k/1%; R_0603_1608Metric
R12: 1k/1%; R_0603_1608Metric
R13: 1R/1%; R_0603_1608Metric
R14: 200R/1%; R_0603_1608Metric
R15, R16: 100mR/1W; R_2512_6332Metric
U2: TMC2209; QFN-28-1EP_5x5mm_P0.5mm_EP3.35x3.35mm_ThermalVias

Connections:
+5V: C20.1, D11.1 (K), U2.15 (VCC_IO); also elsewhere on the board
+12V: C15.1, C16.1, C17.1, C18.1, C19.1, C22.1, C23.1, D5.1 (K), U2.22 (VS), U2.28 (VS); also elsewhere on the board
/SERVO_DIAG: R14.2, U2.11 (DIAG); also elsewhere on the board
/SERVO_DIR: U2.19 (DIR); also elsewhere on the board
/SERVO_ENN: U2.2 (ENN); also elsewhere on the board
/SERVO_INDEX: U2.12 (INDEX); also elsewhere on the board
/SERVO_STEP: U2.16 (STEP); also elsewhere on the board
/SERVO_UART_RX: R12.1, U2.14 (PDN_UART); also elsewhere on the board
/SERVO_UART_TX: R12.2; also elsewhere on the board
/TMC2209/OA1: U2.24 (OA1); also elsewhere on the board
/TMC2209/OA2: U2.21 (OA2); also elsewhere on the board
/TMC2209/OB1: U2.26 (OB1); also elsewhere on the board
/TMC2209/OB2: U2.1 (OB2); also elsewhere on the board
GND: C15.2, C16.2, C17.2, C18.2, C19.2, C20.2, C24.2, D5.2 (A), D6.2 (A), D7.1 (K), D11.2 (A), R11.2, R13.2, R15.2, R16.2, U2.3 (GND), U2.13 (CLK), U2.18 (GND), U2.29 (PAD); also elsewhere on the board
unnamed: C21.1, U2.4 (CPO)
unnamed: C21.2, U2.5 (CPI)
unnamed: C22.2, R13.1
unnamed: C23.2, U2.6 (VCP)
unnamed: C24.1, D6.1 (K), U2.8 (5VOUT)
unnamed: D7.2 (A), R14.1
unnamed: R11.1, U2.20 (STDBY)
unnamed: R15.1, U2.27 (BRB)
unnamed: R16.1, U2.23 (BRA)

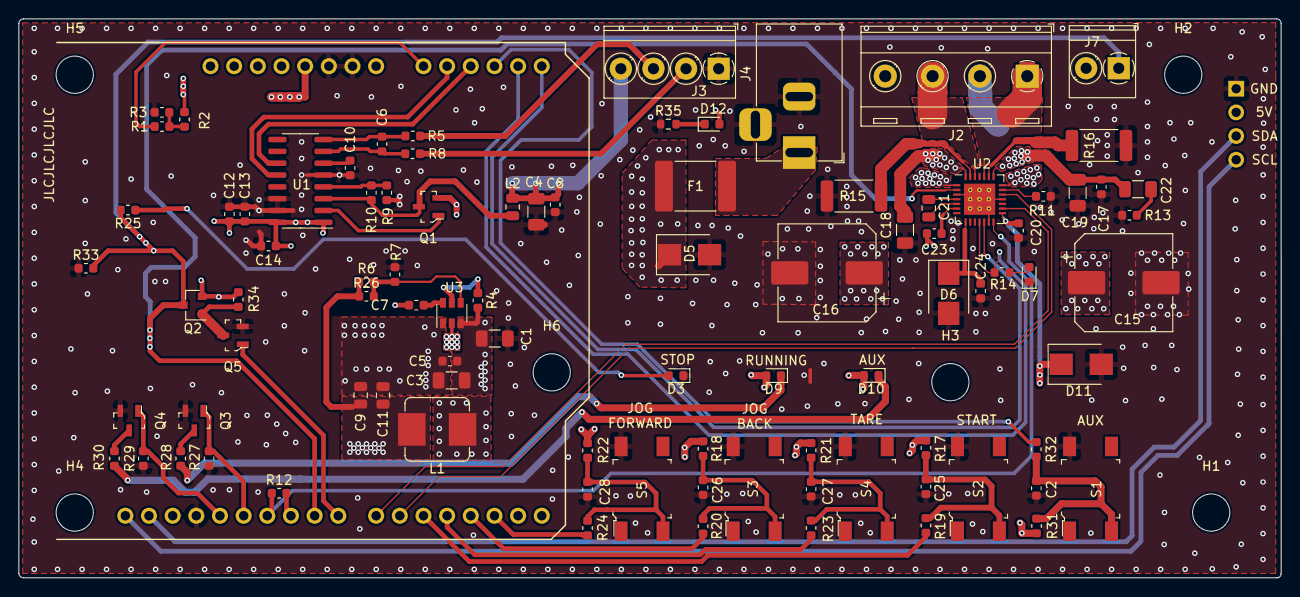
[picture p28: board MMTK.kicad_pcb from above]

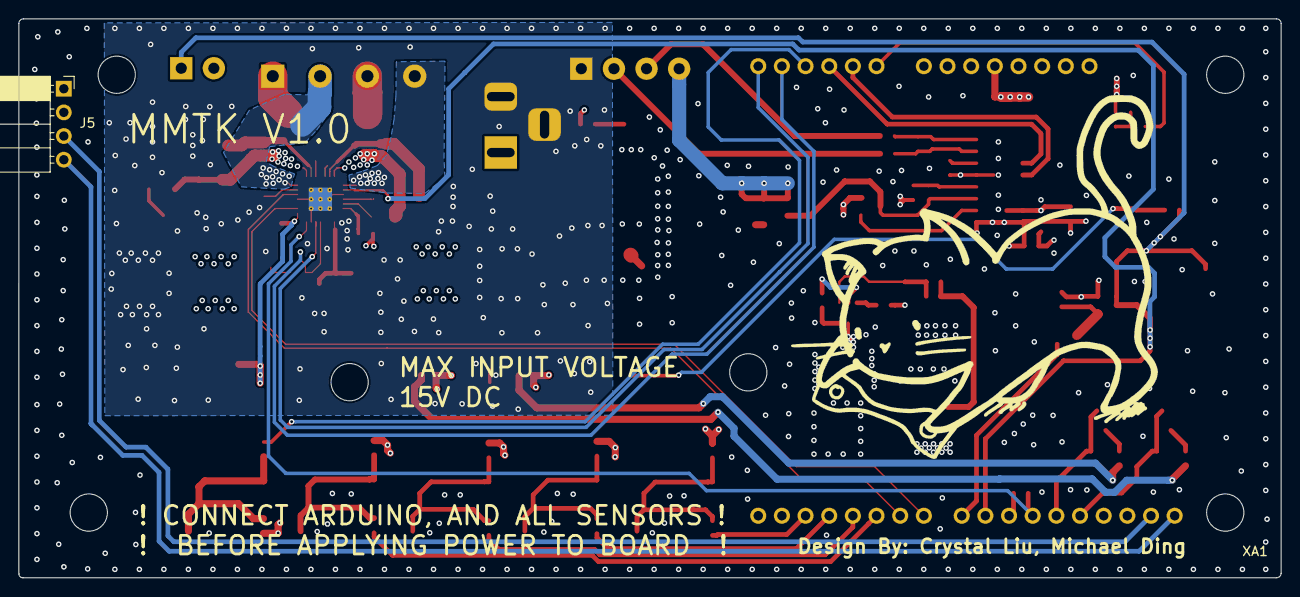
[picture p29: board MMTK.kicad_pcb from below]

Board: 4 copper layers, 135.5 x 60.0 mm, 100 parts (3 on the bottom side), 63 nets.
