crystalliu314/MMTK/(commit log)

2020-12-08 Added code to just spin motor
2020-12-11 Added button control direction
    use botton to control direction
    this is a bit sketch
2020-12-12 Add PCB Files
    Added PCB files, preliinary for now
    [4x30mm pin.SLDPRT, Buttons.sch, ESTOP.sch, HX771.sch, Inner Pin.SLDPRT, LCD.sch, LEDs.sch, MMTK - For Test Bed v1.5.SLDASM]
2020-12-23 Code Mostly Done
    Leaving code in QA folder for now, official code will be released later
    [MMTK First Tests.xlsx]
2020-12-23 Bug fixes
    Bugs mostly ironed out i think,
    Firmware done for now
    [MMTK_V1.h]
2021-01-01 updated ui and code
    more work
    correction for machine deflection is in the works but not done yet
    [GraphClass.pde, MMTK_V1.h, UIConstants.pde]
2021-01-24 Fix typos
    Displacement and mm/min
    [MMTK_UI.pde]
2021-01-24 Edit banner and fix typos
    [UIConstants.pde]
2021-02-02 control frame updates; added 5kg calibration
2021-02-06 Serial port bug fix
    [MMTK_UI.pde]
2021-02-17 Persist Calibration by EEPROM
    We now store calibration with EEPROM.
    Default values will be used if EEPROM is not initialized.
    Changed calibration code to avgerage loadcell values
2021-02-17 Release code with updated spring scale calibration
2021-02-17 Updated UI with separate calibration file
    Updated UI with separate calibration file in case of accidental click on calibration button during normal use
2021-02-17 Exported calibration UI for 64bit
2021-02-17 Update default speed to 50mm/min
2021-04-13 PCB Production file name update
2021-06-16 Add PDF, fix gitignore
    gitignore was too broad and removed lib files for kicad. That is fix.
    updated pdf schematics to include latest changes (not yet manufacturered)
2025-04-05 update and upgrade to kicad9
    [MMTK.kicad_pcb]
